ahmedkamel97/Hands-On-Labs-Imagine-Cup/Images/Streaming setup.jpg

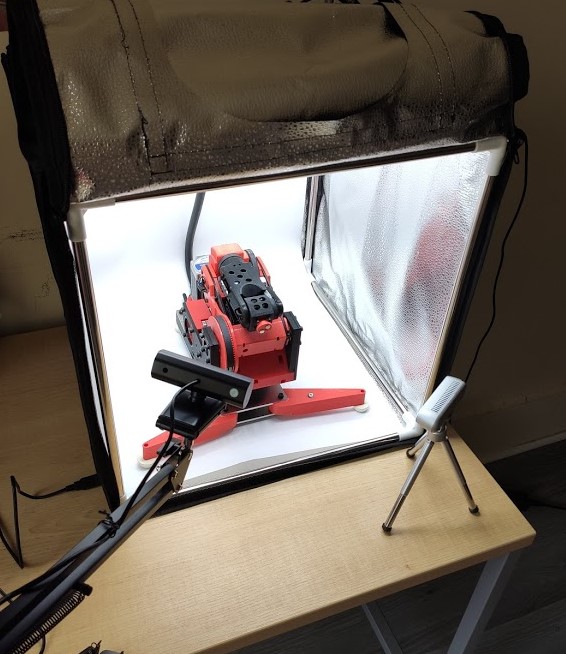
Images/Streaming setup.jpg
