ahmedkamel97/Hands-On-Labs-Imagine-Cup/Images/129480884_4600648436672427_6862320094180525154_n.jpg

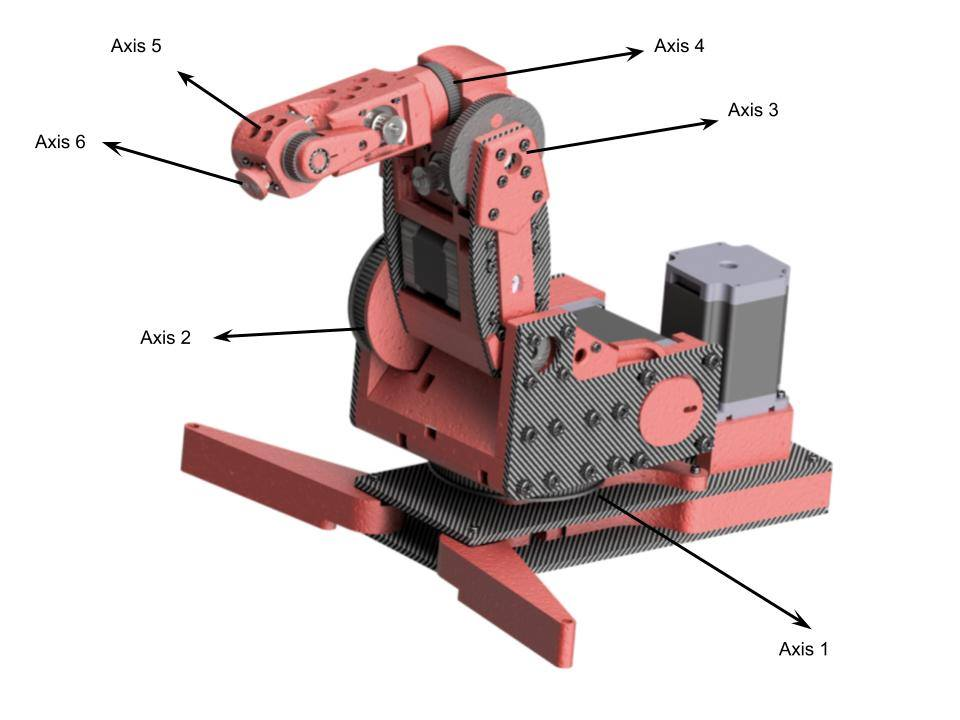
Images/129480884_4600648436672427_6862320094180525154_n.jpg
