ahmedkamel97/Hands-On-Labs-Imagine-Cup/Images/Arm Front view.jpg

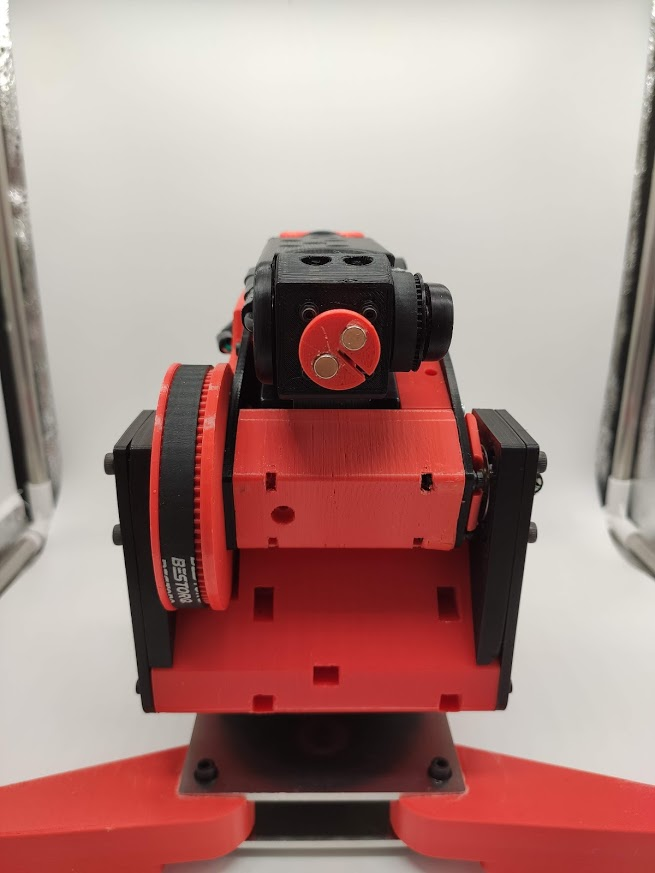
Images/Arm Front view.jpg
