ahmedkamel97/Hands-On-Labs-Imagine-Cup/Images/Capture2.PNG

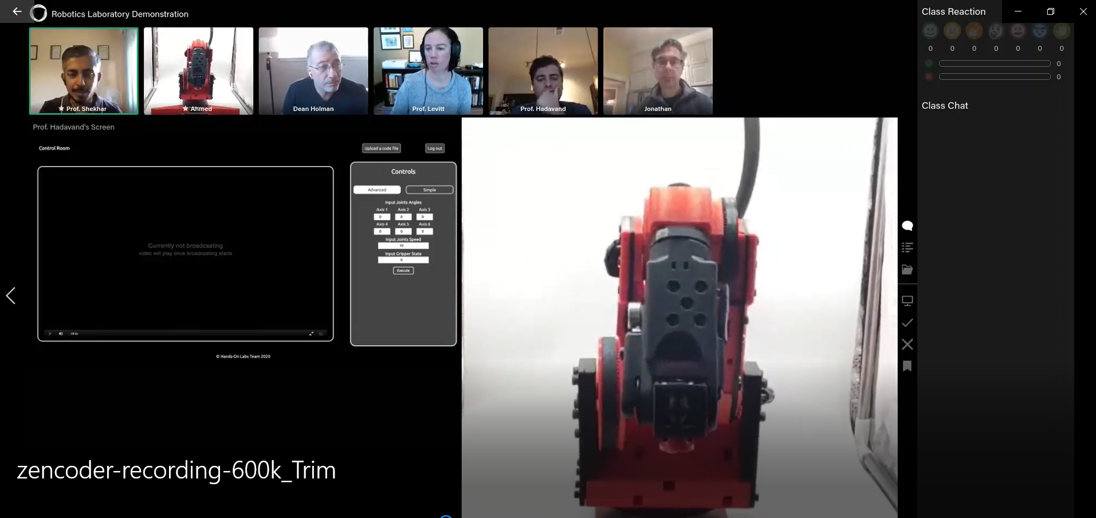
Images/Capture2.PNG
