ahmedkamel97/Hands-On-Labs-Imagine-Cup/Images/Capture.PNG

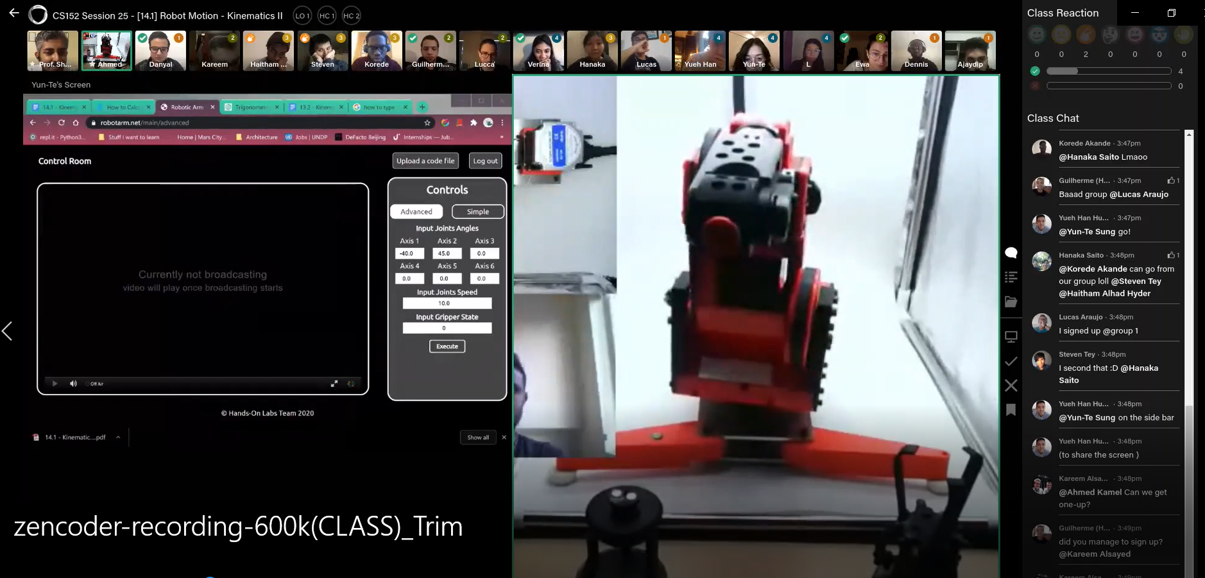
Images/Capture.PNG
