ahmedkamel97/Hands-On-Labs-Imagine-Cup/Images/newplot.png

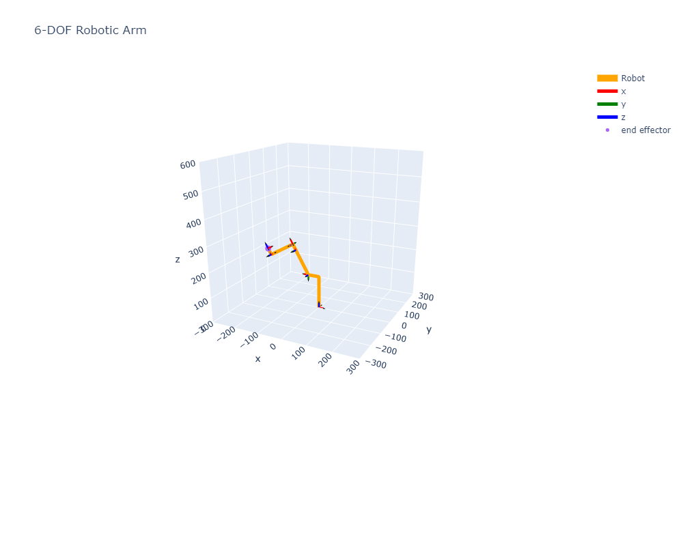
Images/newplot.png
