ahmedkamel97/Hands-On-Labs-Imagine-Cup/Images/robot geometry.PNG

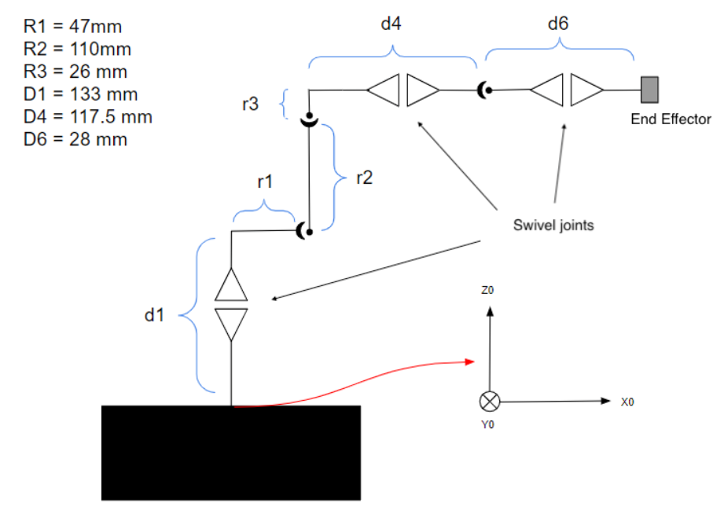
Images/robot geometry.PNG
