ahmedkamel97/Hands-On-Labs-Imagine-Cup/Images/wireframe.PNG

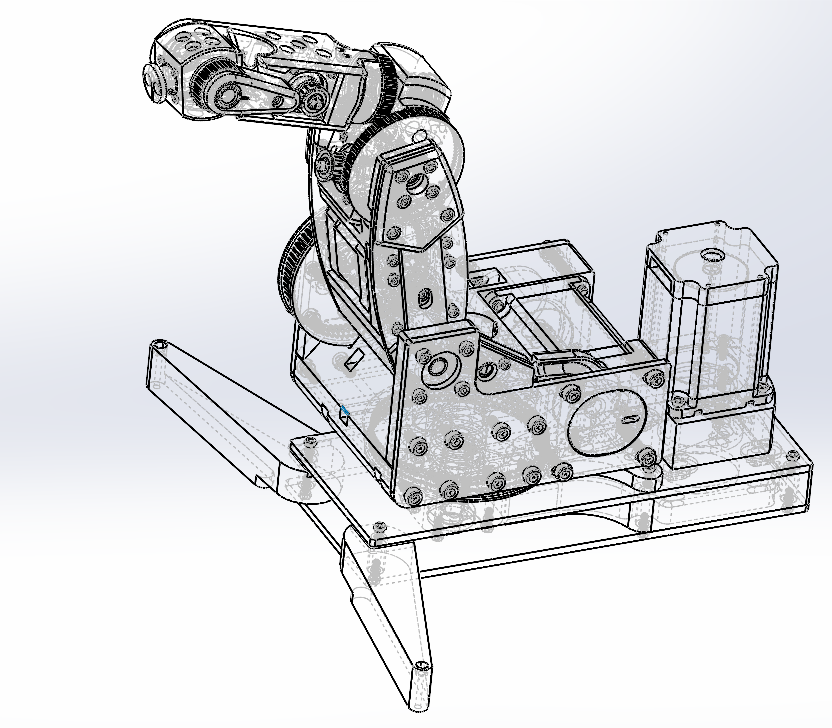
Images/wireframe.PNG
