ahmedkamel97/Hands-On-Labs-Imagine-Cup/Guides/Electrical Assembly Manual.pdf

# ELECTRICAL ASSEMBLY MANUAL

ALL YOU NEED TO KNOW TO ELECTRICALLY ASSEMBLE THE ROBOTIC ARM

# AHMED KAMEL

# Hands-On Labs

A Virtual Hands-on Lab Experience

### Components and Tools

A complete list with all the components and the tools required for this assembly can be found HERE. (https://docs.google.com/spreadsheets/d/1xqng5Fbj06bplTsiMsNVd0amX0TiUSmSYblq1xCeGWM/edit?usp=sharing)

### Electrical Assembly Manual

Robotic Arm Module Wiring

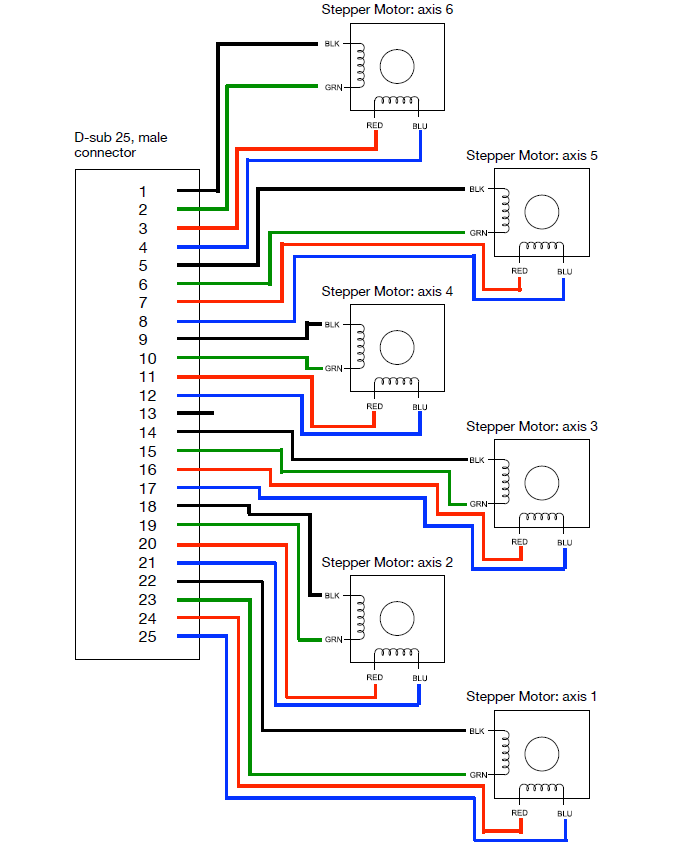
[picture p9: figure]

Motion Controllers Wiring by Axis:

Axis 6 (Nema 8 Stepper Motor) Low Current:

1. Connect the two highlighted terminals on the TMC2130 motor driver using soldering wire as it will be operating in standalone mode.

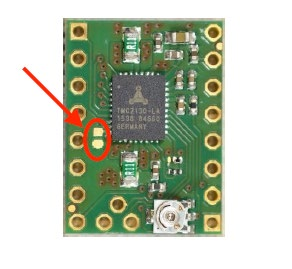
[picture p10: figure]

2. Connect the motor with the TMC2130 motor driver and the Arduino Mega as shown in the schematic below. The current value should not exceed 0.6A

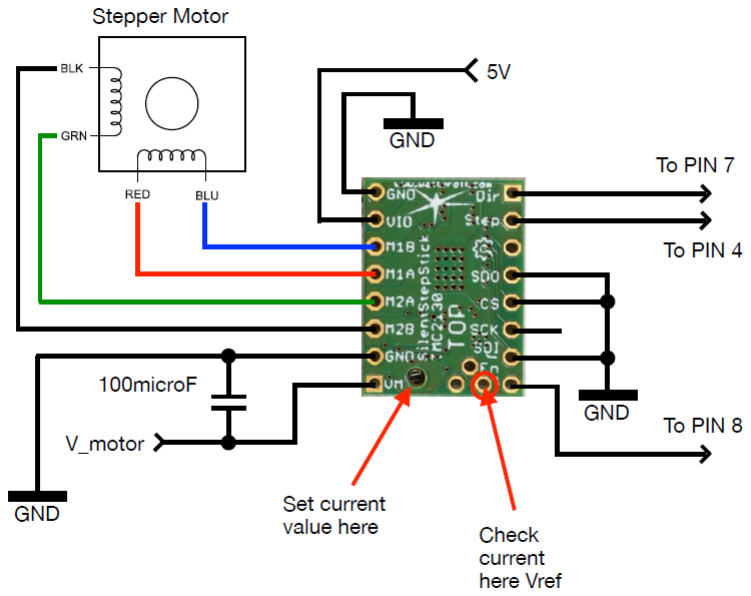
[picture p11: figure]
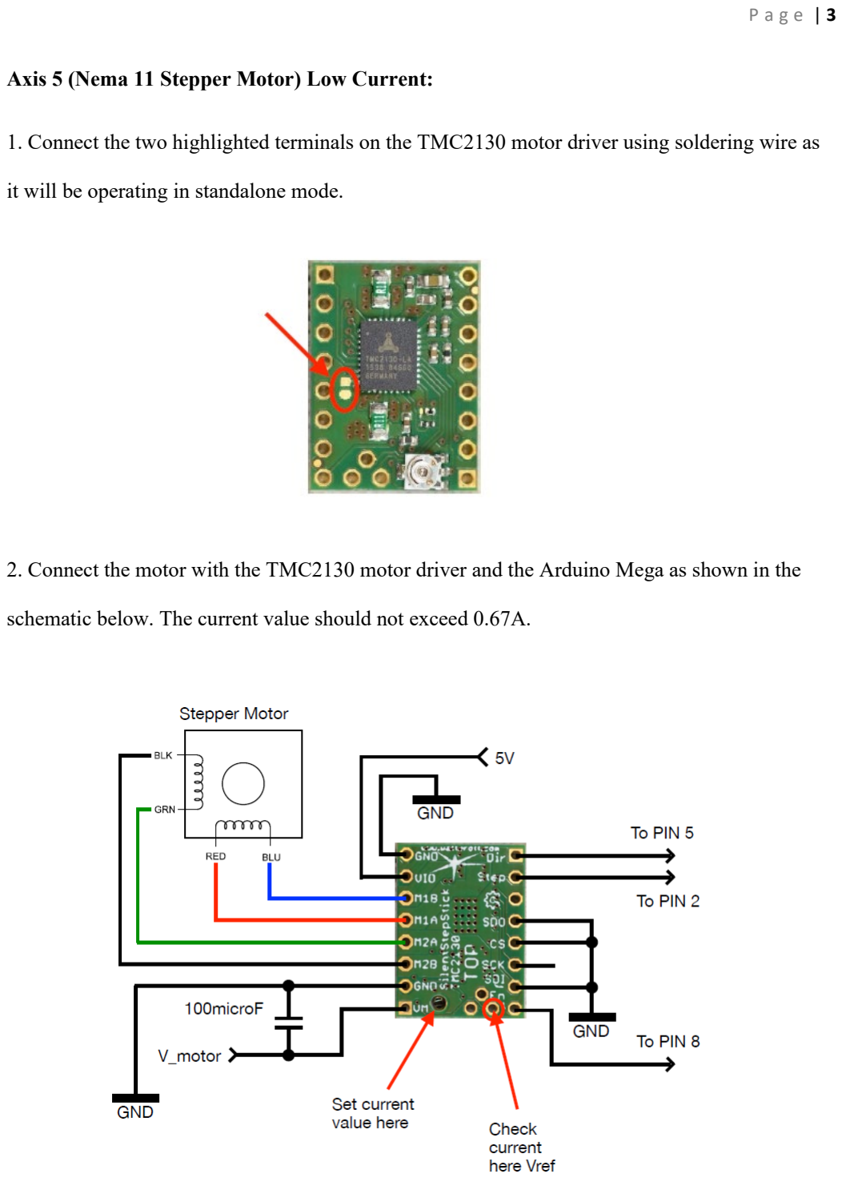
[picture p12: page 4]

Axis 5 (Nema 11 Stepper Motor) Low Current:

1. Connect the two highlighted terminals on the TMC2130 motor driver using soldering wire as it will be operating in standalone mode.
2. Connect the motor with the TMC2130 motor driver and the Arduino Mega as shown in the schematic below. The current value should not exceed 0.67A.

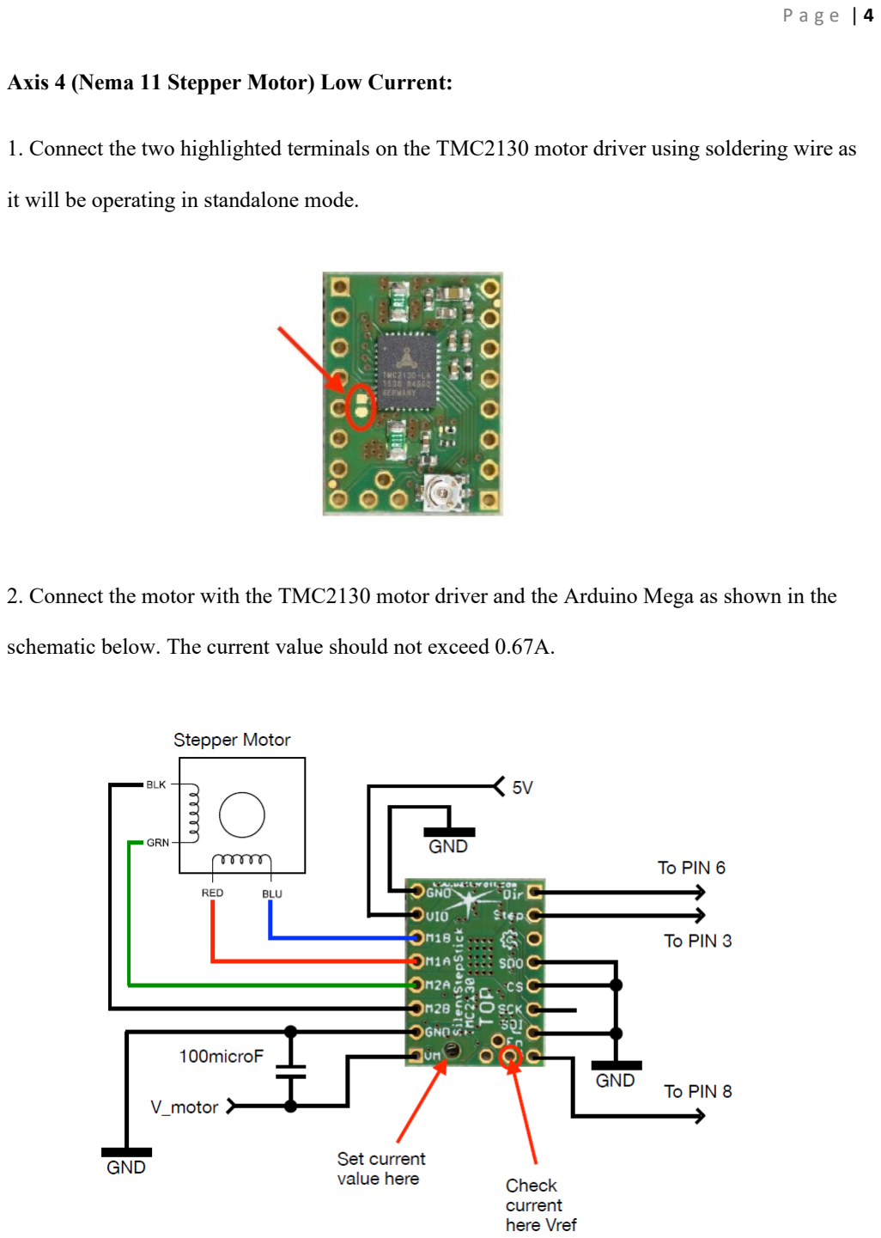
[picture p13: page 5]

Axis 4 (Nema 11 Stepper Motor) Low Current:

1. Connect the two highlighted terminals on the TMC2130 motor driver using soldering wire as it will be operating in standalone mode.
2. Connect the motor with the TMC2130 motor driver and the Arduino Mega as shown in the schematic below. The current value should not exceed 0.67A.

Axis 3 (Nema 17 Stepper Motor) High Current:

1. Connect the motor with the TMC1110 motor driver and the Arduino Mega as shown in the schematic below. The current value should not exceed 0.85A. Please refer to the module datasheet for information about setting the current.

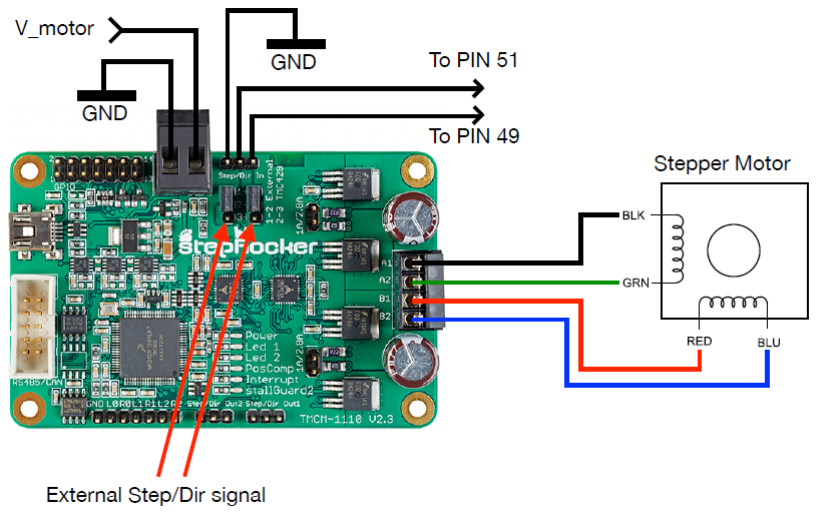
[picture p14: figure]

Axis 2 (Nema 23 Stepper Motor) High Current:

1. Connect the motor with the TMC1110 motor driver and the Arduino Mega as shown in the schematic below. The current value should not exceed 2.80A. Please refer to the module datasheet for information about setting the current.

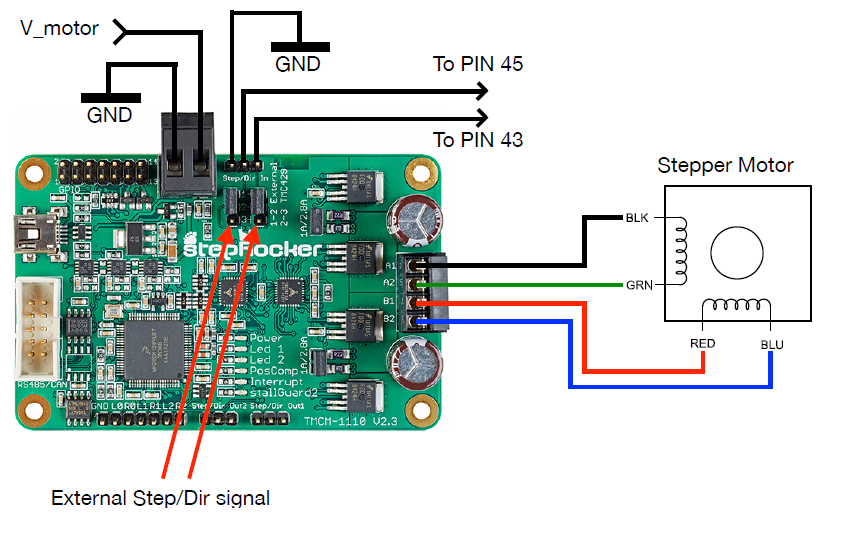
[picture p15: figure]

Axis 1 (Nema 23 stepper Motor) High Current:

1. Connect the motor with the TMC1110 motor driver and the Arduino Mega as shown in the schematic below. The current value should not exceed 2.80A. Please refer to the module datasheet for information about setting the current.

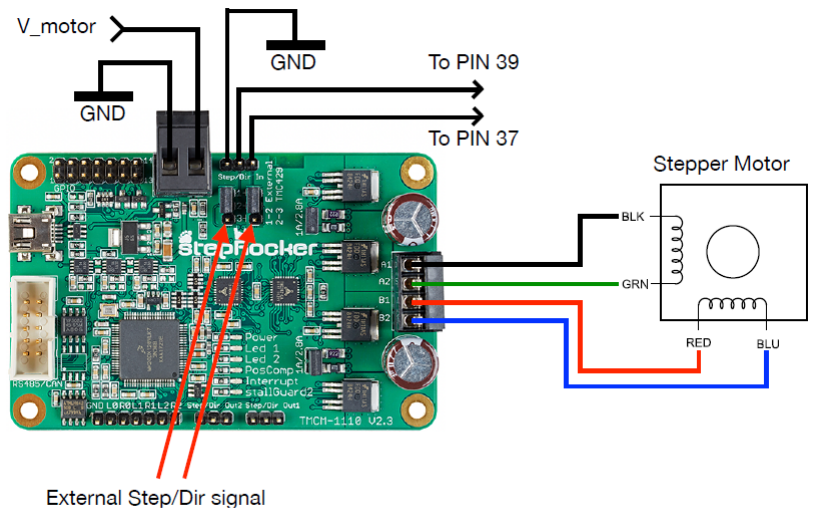
[picture p16: figure]
